Zwackelmann/brewbot/3D/temp-module-bot-case.stl

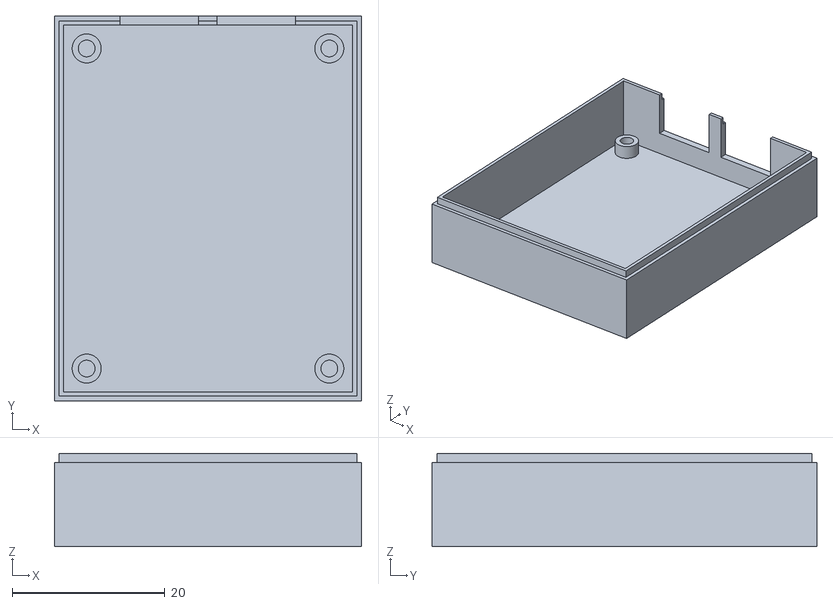
[picture p1: CAD file, 2024-01-14]
3D/temp-module-bot-case.stl
40.2 x 50.4 x 12.2
