Zwackelmann/brewbot/3D/temp-module.FCStd

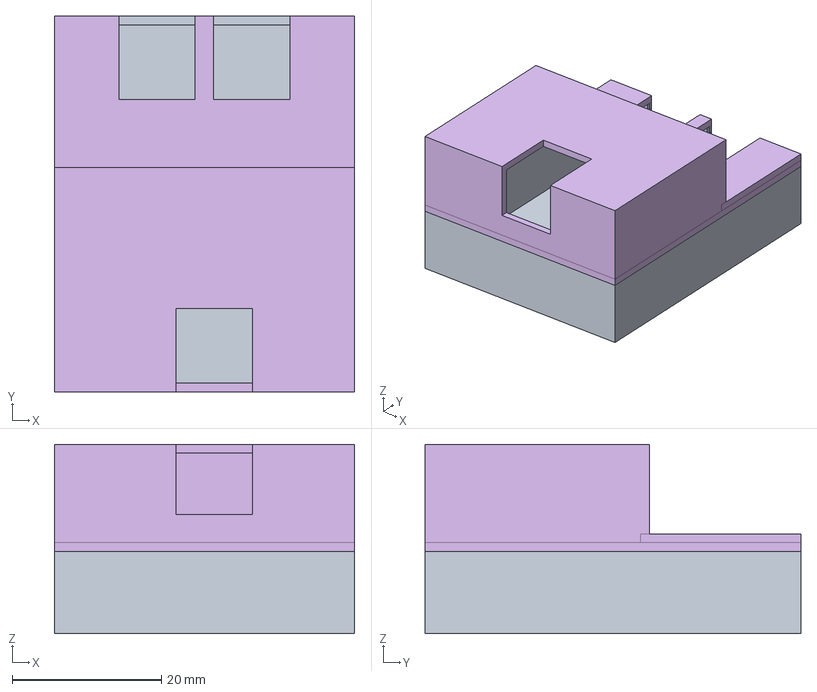
[picture p2: CAD file, 2024-01-14]
3D/temp-module.FCStd
40.2 x 50.4 x 25.4 mm
Tube
Tube001
Tube002
Tube003
