Zwackelmann/brewbot/3D/temp-module-top-case.stl

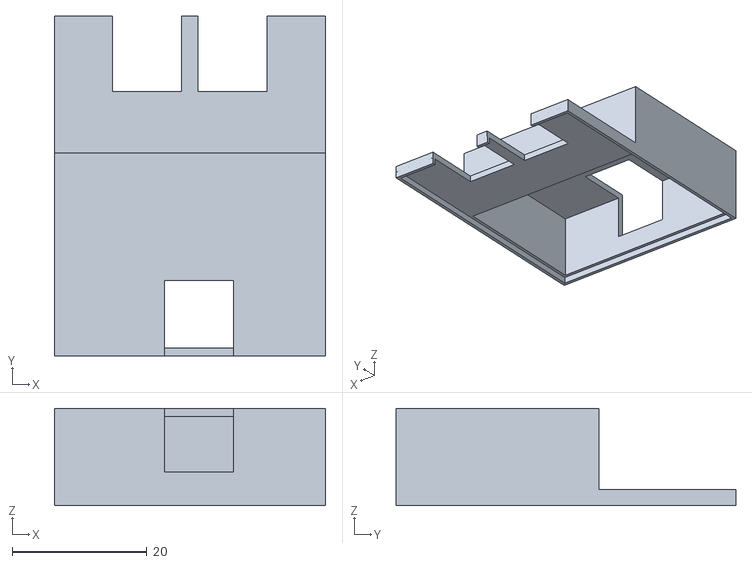
[picture p3: CAD file, 2024-01-14]
3D/temp-module-top-case.stl
40.2 x 50.4 x 14.4
