Zwackelmann/brewbot/3D/screw_demo.FCStd

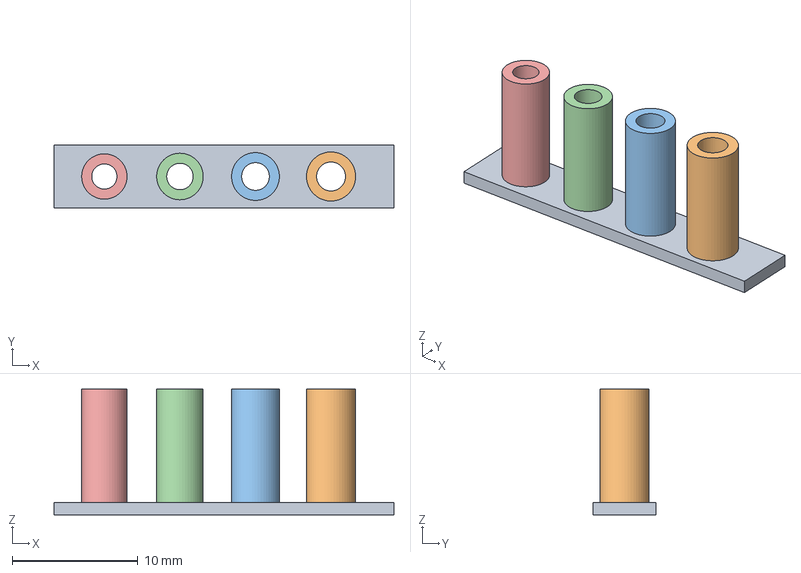
[picture p4: CAD file, 2024-01-06]
3D/screw_demo.FCStd
27.0 x 5.00 x 10.0 mm
