Zwackelmann/brewbot/pcb/motor-module/motor-module.kicad_pcb

## KiCad design pcb/motor-module/motor-module.kicad_pcb (2025-08-07)

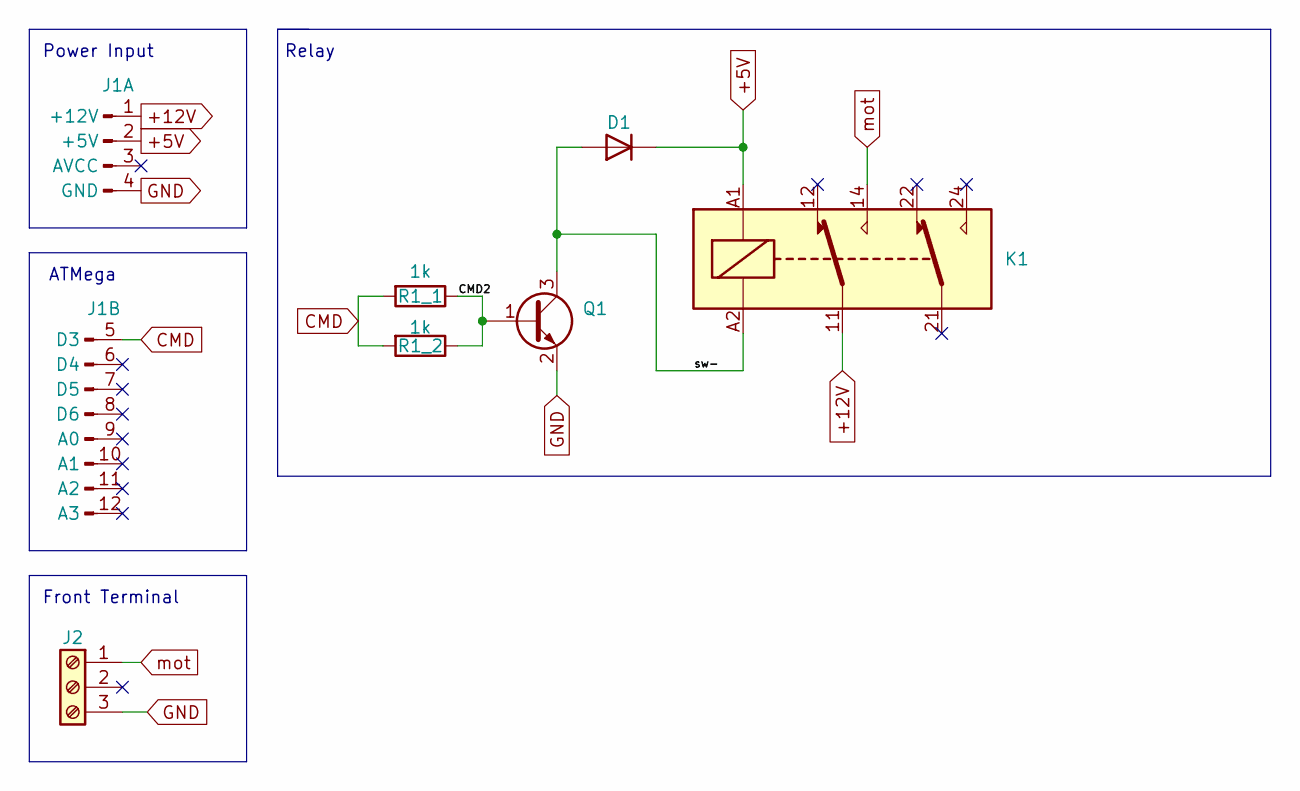
[picture p5: schematic motor-module.kicad_sch]

Parts:
D1: GS1A Gleichrichterdiode, 50 V, 1 A, DO-214AC/SMA; D_SMA
J1: Connector_male_4x8
J2: Screw_Terminal_01x03; Wago_734-163_1x03_P3.50mm_Horizontal
K1: AZ822-2C-5DSE Signal-Relais, 5 V DC, 2 A, 2 CO; Relay_DPDT_Finder_30.22
Q1: 2N 2222A SMD Bipolartransistor, NPN, 40V, 0,8A, 0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; SOT-23
R1_1, R1_2: 1k; R_0805_2012Metric

Connections:
+5V: D1.1 (K), J1.2 (+5V), K1.A1
+12V: J1.1 (+12V), K1.11
/CMD2: Q1.1 (B), R1_1.1, R1_2.1
/sw-: D1.2 (A), K1.A2, Q1.3 (C)
CMD: J1.5 (D3), R1_1.2, R1_2.2
GND: J1.4 (GND), J2.3, Q1.2 (E)
mot: J2.1, K1.14

Notes on the sheet:
ATMega
Power Input
Relay
Front Terminal

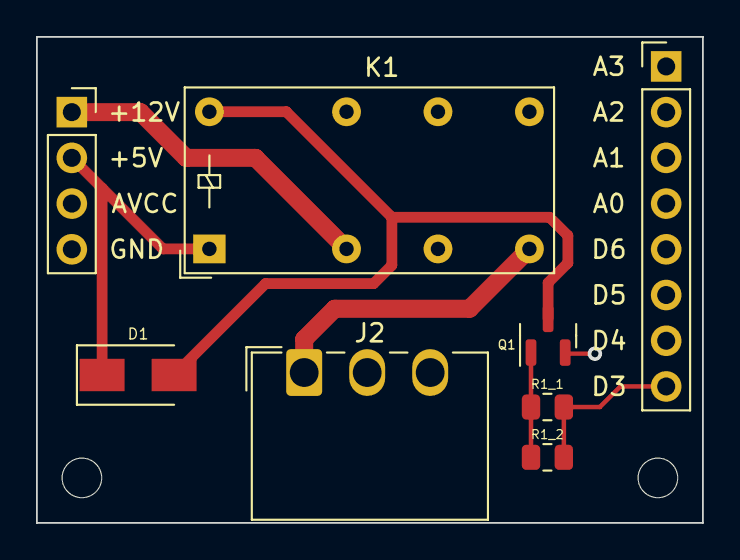
[picture p6: board motor-module.kicad_pcb from above]

Board: 2 copper layers, 37.0 x 27.0 mm, 7 parts (0 on the bottom side), 7 nets.
