Zwackelmann/brewbot/pcb/can-atmega/can-atmega.kicad_pcb

## KiCad design pcb/can-atmega/can-atmega.kicad_pcb (2025-07-05)

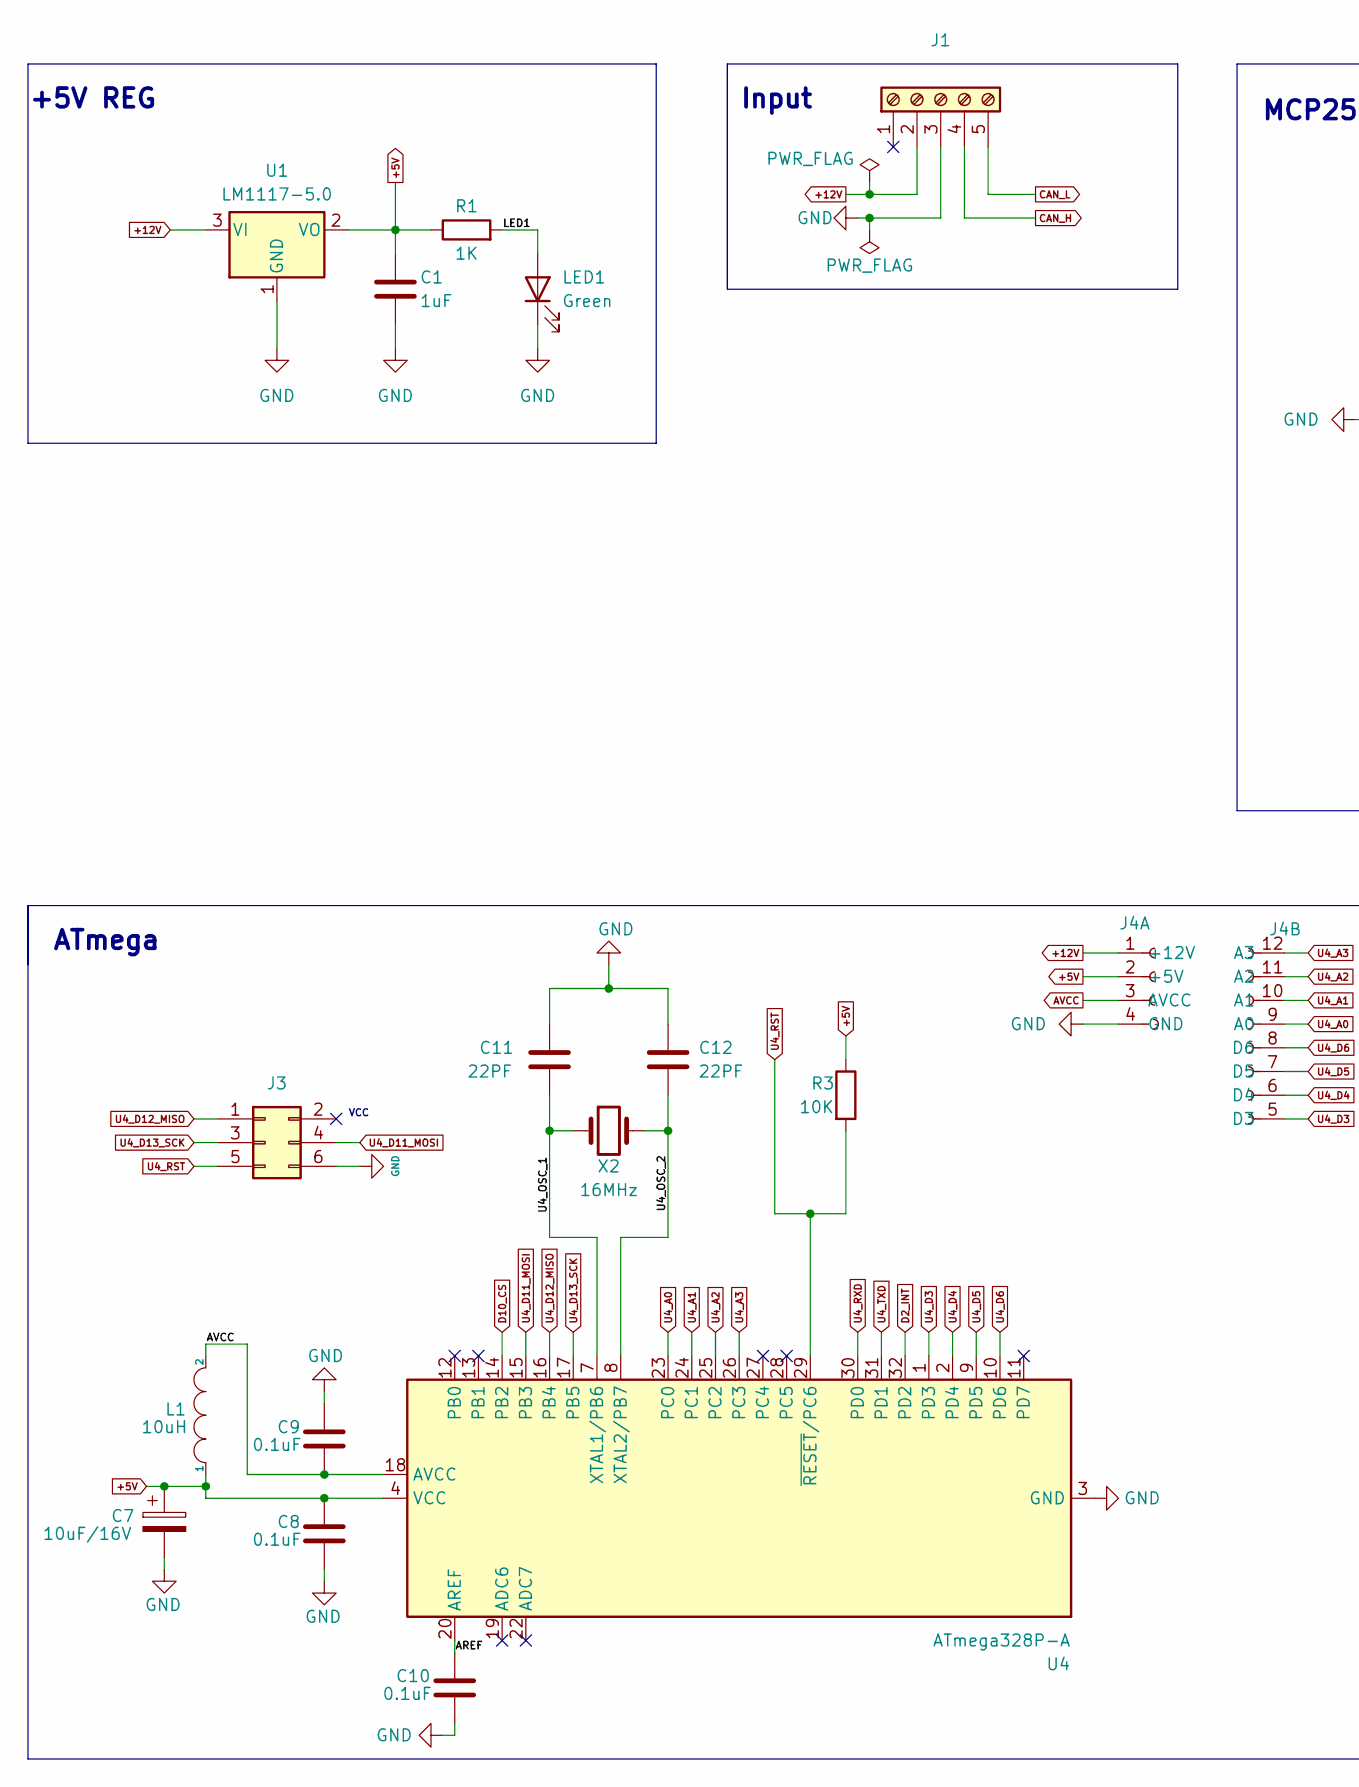
[picture p7: schematic can-atmega.kicad_sch, part in row 1, column 1]

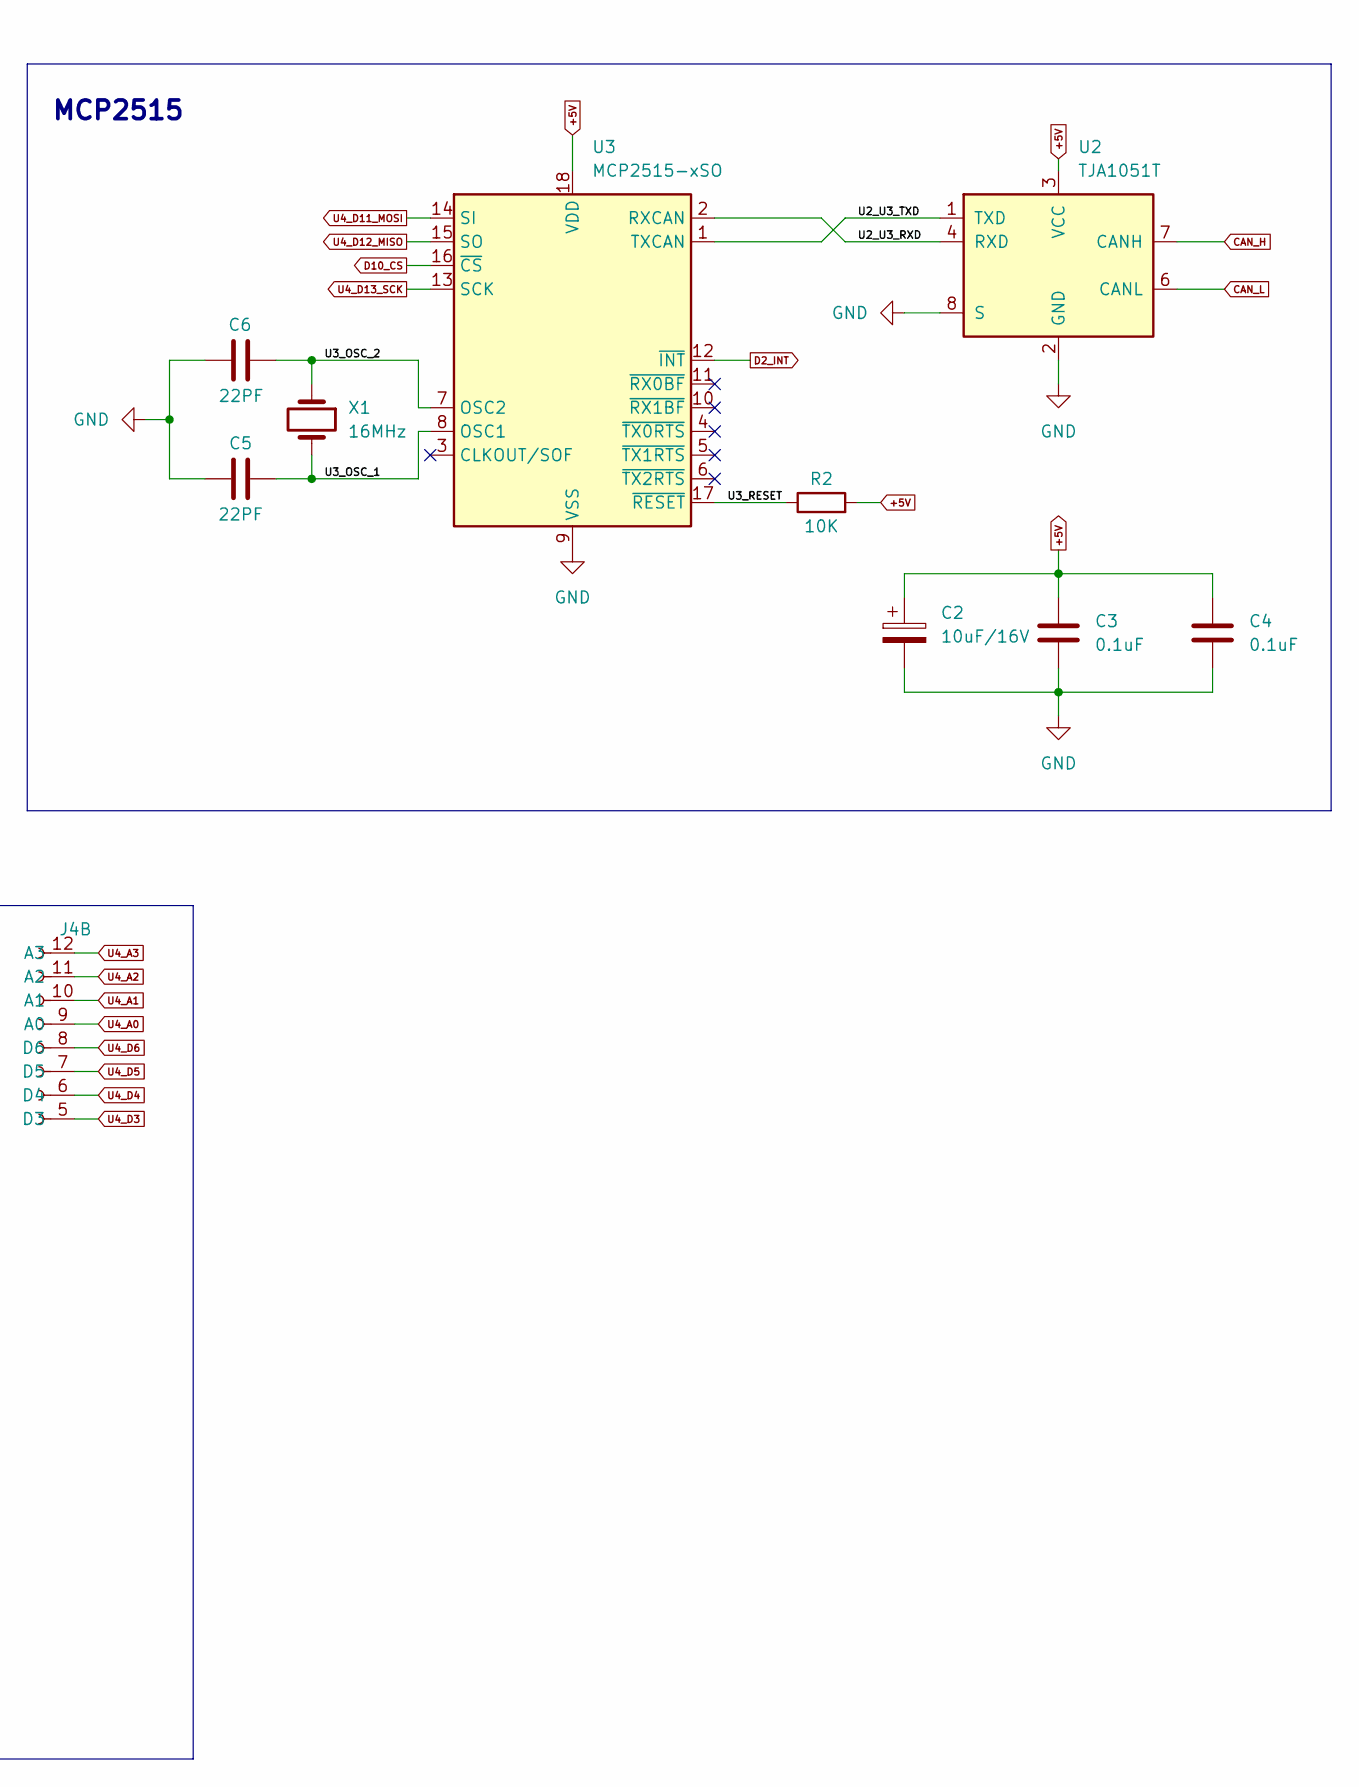
[picture p8: schematic can-atmega.kicad_sch, part in row 1, column 2]

Parts:
C1: 1uF; C_1206_3216Metric
C2, C7: 10uF/16V; CP_EIA-3216-18_Kemet-A
C3, C4, C8, C9, C10: 0.1uF; C_1206_3216Metric
C5, C6, C11, C12: 22PF; C_1206_3216Metric
J1: Screw_Terminal_01x05; 4301207
J3: Conn_02x03_Odd_Even; IDC-Header_2x03_P2.54mm_Vertical
J4: Connector_female_4x8
L1: 10uH; L_Neosid_SMS-ME3010
LED1: Green; LED_0805_2012Metric
R1: 1K; R_0805_2012Metric
R2, R3: 10K; R_0805_2012Metric
U1: LM1117-5.0; SOT-223
U2: TJA1051T; SOIC-8_3.9x4.9mm_P1.27mm
U3: MCP2515-xSO; SOIC-18W_7.5x11.6mm_P1.27mm
U4: ATmega328P-A; TQFP-32_7x7mm_P0.8mm
X1, X2: 16MHz; Crystal_HC49-4H_Vertical

Connections:
+5V: C1.1, C2.1, C3.1, C4.1, C7.1, C8.1, J4.2 (+5V), L1.1, R1.1, R2.2, R3.1, U1.2 (VO), U1.4, U2.3 (VCC), U3.18 (VDD), U4.4 (VCC), U4.6 (VCC)
+12V: J1.2, J4.1 (+12V), U1.3 (VI)
/AREF: C10.2, U4.20 (AREF)
/LED1: LED1.2 (A), R1.2
/U2_U3_RXD: U2.4 (RXD), U3.2 (RXCAN)
/U2_U3_TXD: U2.1 (TXD), U3.1 (TXCAN)
/U3_OSC_1: C5.2, U3.8 (OSC1), X1.2
/U3_OSC_2: C6.2, U3.7 (OSC2), X1.1
/U3_RESET: R2.1, U3.17 (~RESET)
/U4_OSC_1: C11.1, U4.7 (XTAL1/PB6), X2.1
/U4_OSC_2: C12.2, U4.8 (XTAL2/PB7), X2.2
AVCC: C9.2, J4.3 (AVCC), L1.2, U4.18 (AVCC)
CAN_H: J1.4, U2.7 (CANH)
CAN_L: J1.5, U2.6 (CANL)
D2_INT: U3.12 (~INT), U4.32 (PD2)
D10_CS: U3.16 (~CS), U4.14 (PB2)
GND: C1.2, C2.2, C3.2, C4.2, C5.1, C6.1, C7.2, C8.2, C9.1, C10.1, C11.2, C12.1, J1.3, J3.6, J4.4 (GND), LED1.1 (K), U1.1 (GND), U2.2 (GND), U2.8 (S), U3.9 (VSS), U4.3 (GND), U4.5 (GND), U4.21 (GND)
U4_A0: J4.9 (A0), U4.23 (PC0)
U4_A1: J4.10 (A1), U4.24 (PC1)
U4_A2: J4.11 (A2), U4.25 (PC2)
U4_A3: J4.12 (A3), U4.26 (PC3)
U4_D3: J4.5 (D3), U4.1 (PD3)
U4_D4: J4.6 (D4), U4.2 (PD4)
U4_D5: J4.7 (D5), U4.9 (PD5)
U4_D6: J4.8 (D6), U4.10 (PD6)
U4_D11_MOSI: J3.4, U3.14 (SI), U4.15 (PB3)
U4_D12_MISO: J3.1, U3.15 (SO), U4.16 (PB4)
U4_D13_SCK: J3.3, U3.13 (SCK), U4.17 (PB5)
U4_RST: J3.5, R3.2, U4.29 (~RESET/PC6)
U4_RXD: U4.30 (PD0)
U4_TXD: U4.31 (PD1)

Notes on the sheet:
+5V REG
ATmega
MCP2515
VCC
Input

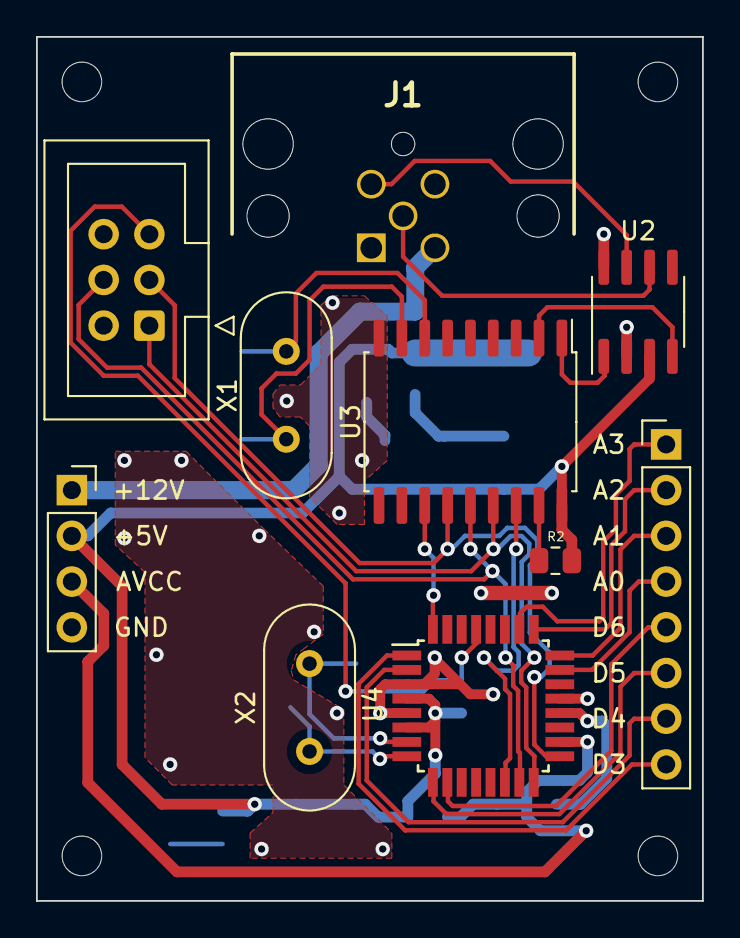
[picture p9: board can-atmega.kicad_pcb from above]

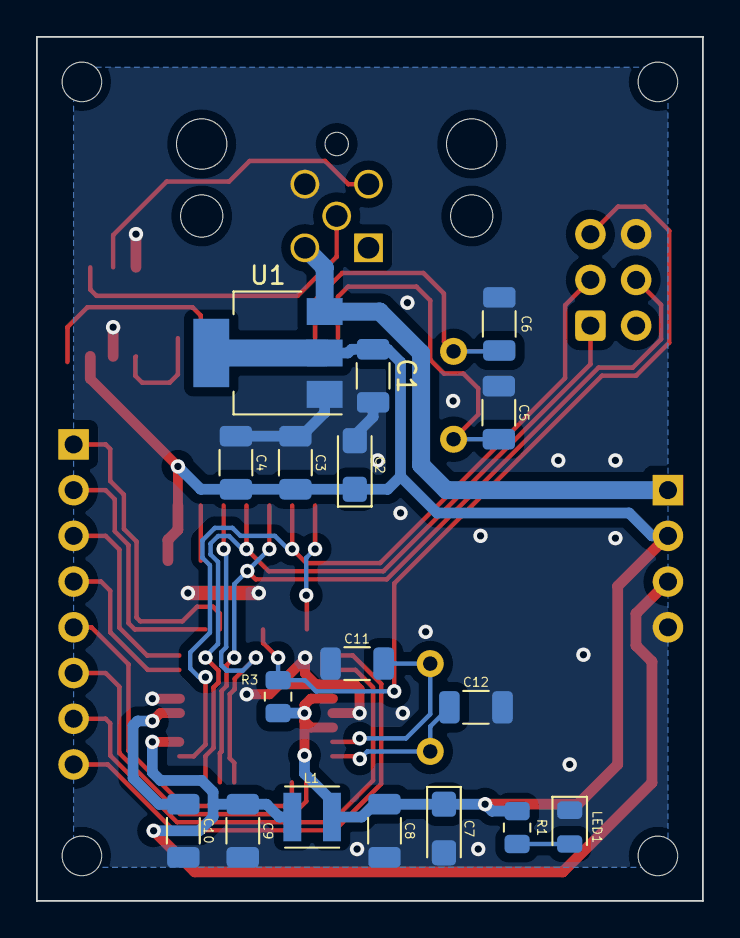
[picture p10: board can-atmega.kicad_pcb from below]

Board: 2 copper layers, 37.0 x 48.0 mm, 26 parts (17 on the bottom side), 29 nets.
