Zwackelmann/brewbot/pcb/temp-module/temp-module.kicad_pcb

## KiCad design pcb/temp-module/temp-module.kicad_pcb (2025-07-03)

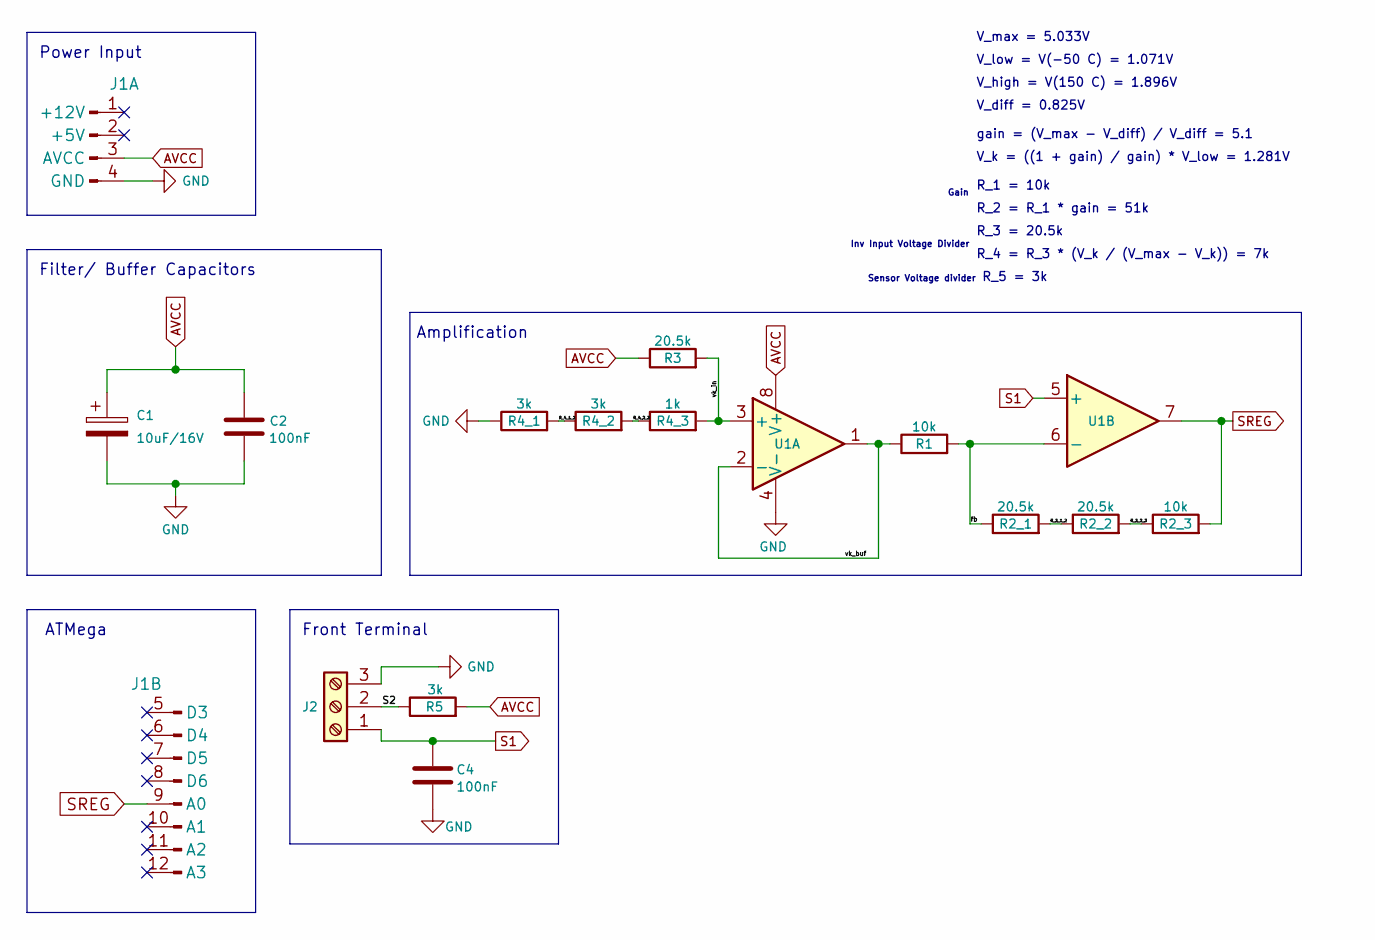
[picture p11: schematic temp-module.kicad_sch]

Parts:
C1: 10uF/16V; C_1206_3216Metric
C2, C4: 100nF; C_1206_3216Metric
J1: Connector_male_4x8
J2: Screw_Terminal_01x03; Wago_734-163_1x03_P3.50mm_Horizontal
R1, R2_3: 10k; R_0805_2012Metric
R2_1, R2_2, R3: 20.5k; R_0805_2012Metric
R4_1, R4_2, R5: 3k; R_0805_2012Metric
R4_3: 1k; R_0805_2012Metric
U1: MCP6002-xP; DIP-8_W7.62mm

Connections:
/R_2_1_2: R2_1.2, R2_2.1
/R_2_2_3: R2_2.2, R2_3.1
/R_4_1_2: R4_1.2, R4_2.1
/R_4_2_3: R4_2.2, R4_3.1
/S2: J2.2, R5.1
/fb: R1.2, R2_1.1, U1.6 (-)
/vk_buf: R1.1, U1.1, U1.2 (-)
/vk_in: R3.2, R4_3.2, U1.3 (+)
AVCC: C1.1, C2.1, J1.3 (AVCC), R3.1, R5.2, U1.8 (V+)
GND: C1.2, C2.2, C4.2, J1.4 (GND), J2.3, R4_1.1, U1.4 (V-)
S1: C4.1, J2.1, U1.5 (+)
SREG: J1.9 (A0), R2_3.2, U1.7

Notes on the sheet:
gain = (V_max - V_diff) / V_diff = 5.1
Inv Input Voltage Divider
Gain
V_high = V(150 C) = 1.896V
R_4 = R_3 * (V_k / (V_max - V_k)) = 7k
V_max = 5.033V
V_diff = 0.825V
Amplification
Front Terminal
Sensor Voltage divider
R_5 = 3k
Filter/ Buffer Capacitors
V_k = ((1 + gain) / gain) * V_low = 1.281V
ATMega
Power Input
V_low = V(-50 C) = 1.071V
R_2 = R_1 * gain = 51k
R_3 = 20.5k
R_1 = 10k

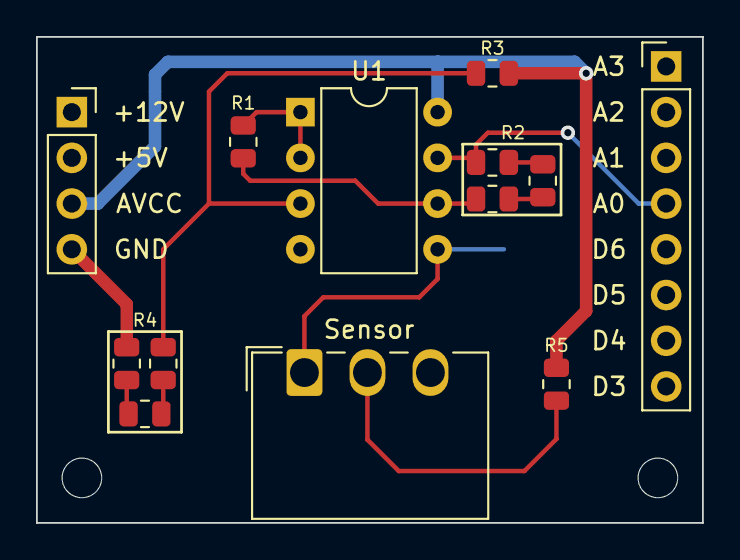
[picture p12: board temp-module.kicad_pcb from above]

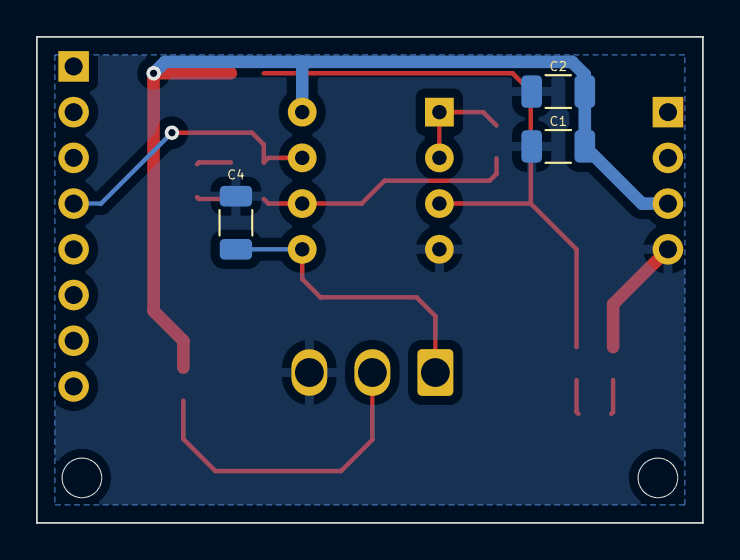
[picture p13: board temp-module.kicad_pcb from below]

Board: 2 copper layers, 37.0 x 27.0 mm, 15 parts (3 on the bottom side), 12 nets.
