Zwackelmann/brewbot/pcb/temp-sensor/temp-sensor.kicad_pcb

## KiCad design pcb/temp-sensor/temp-sensor.kicad_pcb (2024-01-06)

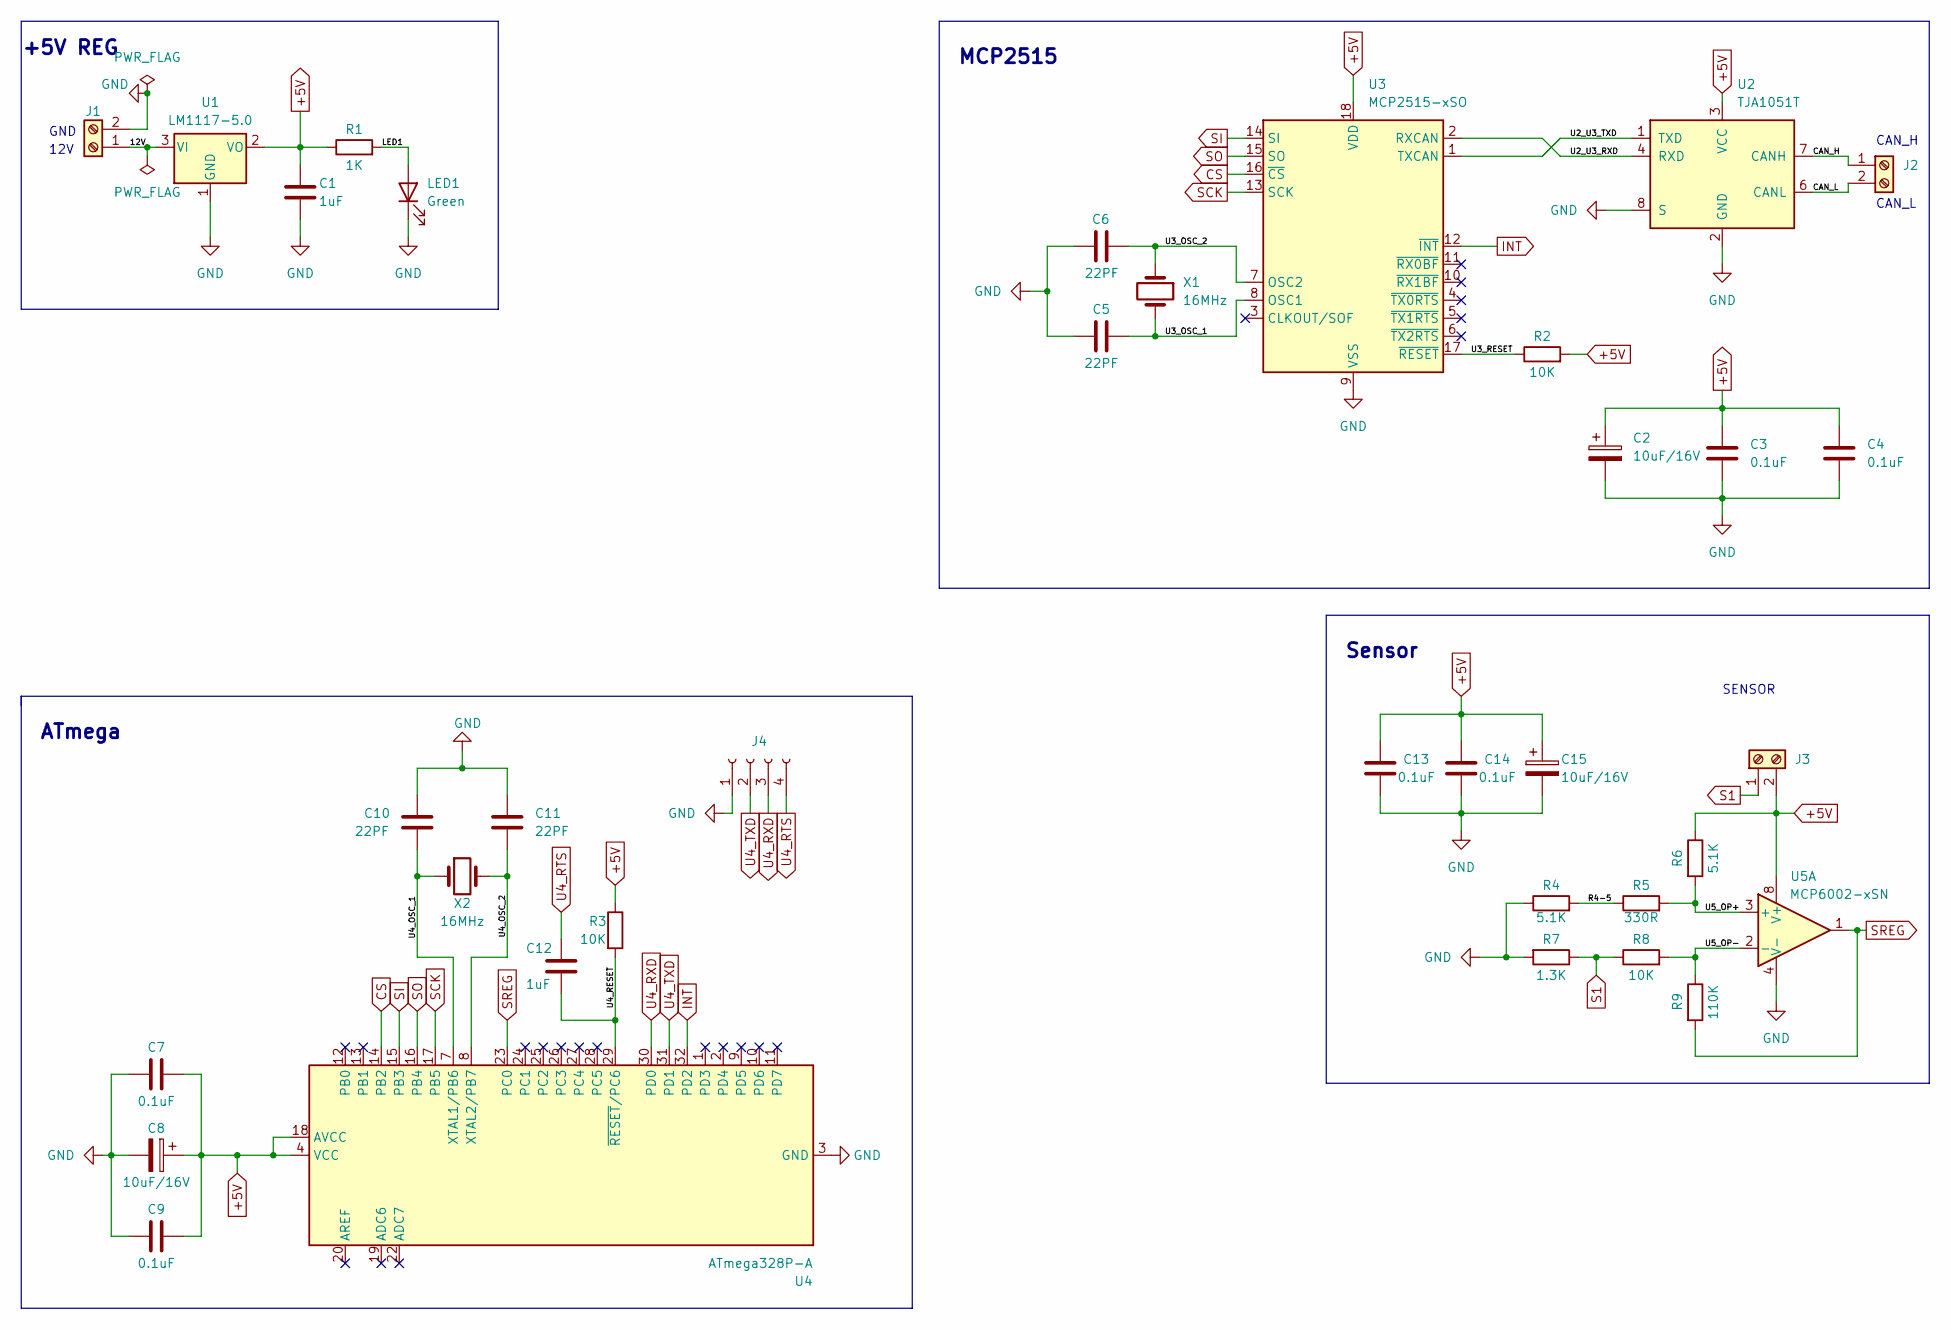
[picture p14: schematic temp-sensor.kicad_sch]

Parts:
C1, C12: 1uF; C_KEM_0805_2.0x1.25mm
C2, C8, C15: 10uF/16V; C_TAJ_3516_Bauform_A
C3, C4, C7, C9, C13, C14: 0.1uF; C_KEM_0805_2.0x1.25mm
C5, C6, C10, C11: 22PF; C_KEM_0805_2.0x1.25mm
J1, J2, J3: Screw_Terminal_01x02; TerminalBlock_bornier-2_P5.08mm
J4: Conn_01x04_Female; PinHeader_1x04_P2.54mm_Vertical
LED1: Green; LED_EL_0603_GR1_1608
R1: 1K; R_SPR-0603_1.6x0.8mm
R2, R3, R8: 10K; R_SPR-0603_1.6x0.8mm
R4, R6: 5.1K; R_SPR-0603_1.6x0.8mm
R5: 330R; R_SPR-0603_1.6x0.8mm
R7: 1.3K; R_SPR-0603_1.6x0.8mm
R9: 110K; R_SPR-0603_1.6x0.8mm
U1: LM1117-5.0; SOT-223
U2: TJA1051T; SOIC-8_3.9x4.9mm_P1.27mm
U3: MCP2515-xSO; SOIC-18W_7.5x11.6mm_P1.27mm
U4: ATmega328P-A; TQFP-32_7x7mm_P0.8mm
U5: MCP6002-xSN; DIP-8_W7.62mm
X1, X2: 16MHz; Crystal_HC49-4H_Vertical

Connections:
+5V: C1.1, C2.1, C3.1, C4.1, C7.1, C8.1, C9.1, C13.1, C14.2, C15.1, J3.2, R1.1, R2.2, R3.1, R6.1, U1.2 (VO), U2.3 (VCC), U3.18 (VDD), U4.4 (VCC), U4.6 (VCC), U4.18 (AVCC), U5.8 (V+)
/12V: J1.1, U1.3 (VI)
/CAN_H: J2.1, U2.7 (CANH)
/CAN_L: J2.2, U2.6 (CANL)
/LED1: LED1.2 (A), R1.2
/R4-5: R4.2, R5.1
/U2_U3_RXD: U2.4 (RXD), U3.2 (RXCAN)
/U2_U3_TXD: U2.1 (TXD), U3.1 (TXCAN)
/U3_OSC_1: C5.2, U3.8 (OSC1), X1.2
/U3_OSC_2: C6.2, U3.7 (OSC2), X1.1
/U3_RESET: R2.1, U3.17 (~RESET)
/U4_OSC_1: C10.1, U4.7 (XTAL1/PB6), X2.1
/U4_OSC_2: C11.2, U4.8 (XTAL2/PB7), X2.2
/U4_RESET: C12.2, R3.2, U4.29 (~RESET/PC6)
/U5_OP+: R5.2, R6.2, U5.3 (+)
/U5_OP-: R8.2, R9.1, U5.2 (-)
CS: U3.16 (~CS), U4.14 (PB2)
GND: C1.2, C2.2, C3.2, C4.2, C5.1, C6.1, C7.2, C8.2, C9.2, C10.2, C11.1, C13.2, C14.1, C15.2, J1.2, J4.1, LED1.1 (K), R4.1, R7.2, U1.1 (GND), U2.2 (GND), U2.8 (S), U3.9 (VSS), U4.3 (GND), U4.5 (GND), U4.21 (GND), U5.4 (V-)
INT: U3.12 (~INT), U4.32 (PD2)
S1: J3.1, R7.1, R8.1
SCK: U3.13 (SCK), U4.17 (PB5)
SI: U3.14 (SI), U4.15 (PB3)
SO: U3.15 (SO), U4.16 (PB4)
SREG: R9.2, U4.23 (PC0), U5.1
U4_RTS: C12.1, J4.4
U4_RXD: J4.3, U4.30 (PD0)
U4_TXD: J4.2, U4.31 (PD1)

Notes on the sheet:
CAN_H
+5V REG
12V
Sensor
CAN_L
ATmega
MCP2515
GND
SENSOR

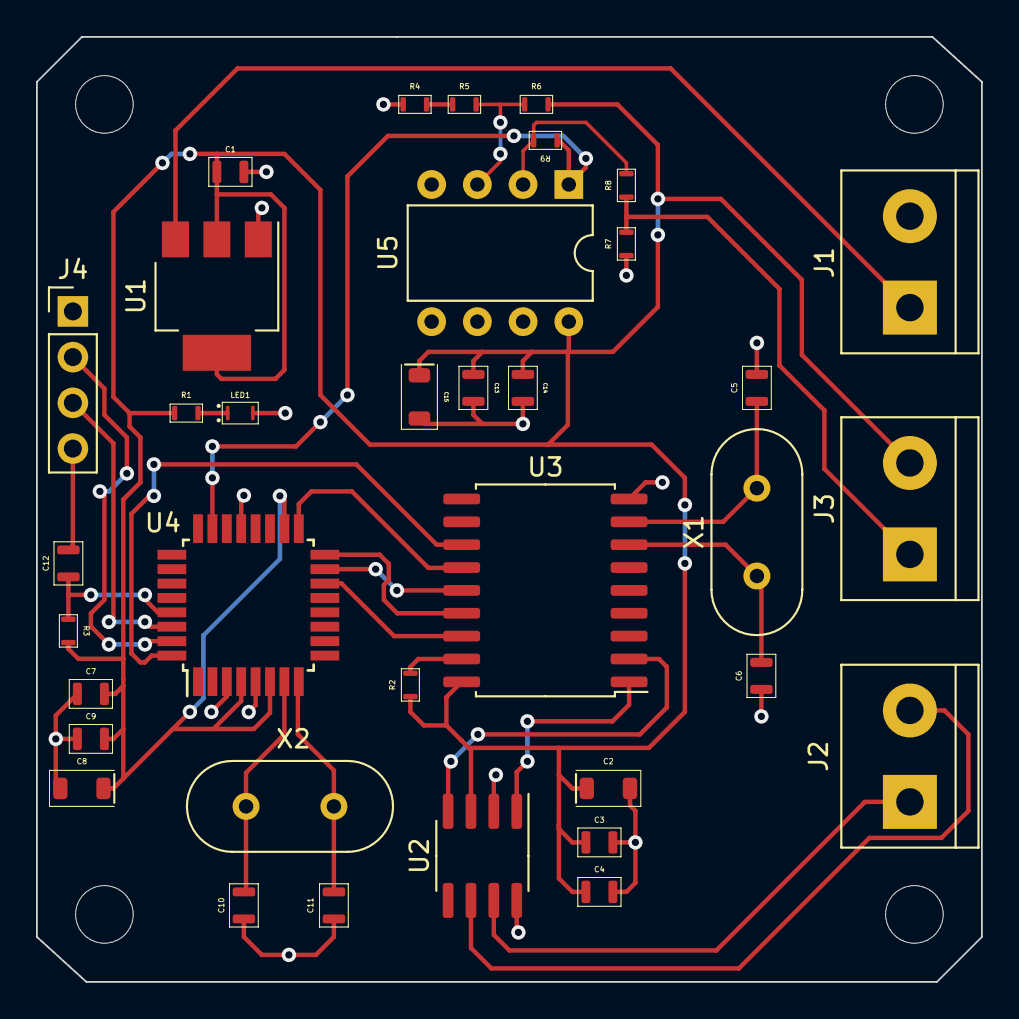
[picture p15: board temp-sensor.kicad_pcb from above]

Board: 2 copper layers, 52.5 x 52.5 mm, 36 parts (0 on the bottom side), 27 nets.
