Zwackelmann/brewbot/arduino/heat_plate_relay/util.h

#ifndef J1939_UTIL_H
#define J1939_UTIL_H

#define NODE_ADDR     0x81u
#define MASTER_ADDR   0x10u
#define NODE_TYPE     NodeType::Relay
#define NODE_ID       1u

#define VERSION_MAJOR 1
#define VERSION_MINOR 10
#define VERSION_PATCH 23

enum class NodeType : uint8_t {
  Unknown     = 0,
  Thermometer = 1,
  Relay       = 2,
  Pressure    = 3,
};

/* Scheduler */
static inline bool time_due(uint32_t now, uint32_t next) {
  return (int32_t)(now - next) >= 0;
}

using schedule_handler_t = void (*)();

struct schedule_item_t {
  uint32_t period_ms;
  uint32_t next_at;
  schedule_handler_t f;
};

template<size_t N>
struct Scheduler {
  schedule_item_t items[N];

  void tick() {
    const uint32_t now = millis();
    for (size_t i = 0; i < N; ++i) {
      auto &it = items[i];
      if (!it.f) continue;
      if (time_due(now, it.next_at)) {
        it.f();
        // catch-up: preserve phase if we slipped
        do { it.next_at += it.period_ms; } while (time_due(now, it.next_at));
      }
    }
  }
};

/* J1939 */
class J1939 {
public:
  static constexpr uint8_t ANY_ADDR = 0xFEu;  // not a real address
  static constexpr uint8_t BROADCAST_ADDR = 0xFFu;
  static constexpr uint32_t CAN_EFF_ID_MASK = 0x1FFFFFFFu;  // 29 bit mask

  static constexpr size_t MAX_MSG_DISPS = 8;

  using dispatch_fn_t = void (*)(const can_frame* frame, void* msg_disp);

  struct reg_item_t {
    uint32_t      pgn;
    size_t        dlc;
    uint8_t       src;     // J1939::ANY_ADDR means "any"
    uint8_t       dest;    // J1939::ANY_ADDR means "any"; J1939::BROADCAST_ADDR is actual 0xFF
    dispatch_fn_t dispatch_fn;
    void*         msg_disp;
  };

  explicit J1939() : _n(0) {}

  static inline uint8_t pdu_format(const uint32_t pgn) noexcept {
    return ((pgn >> 8) & 0xFFu);
  }

  static inline uint8_t is_pdu_format_1(const uint32_t pgn) noexcept {
    return J1939::pdu_format(pgn) < 0xF0u;
  }

  static inline uint8_t is_pdu_format_2(const uint32_t pgn) noexcept {
    return J1939::pdu_format(pgn) >= 0xF0u;
  }

  static inline uint32_t pgn_to_can_id(const uint32_t pgn, const uint8_t priority, const uint8_t src_addr, const uint8_t dest_addr) noexcept {
    uint32_t pgn_encoded = pgn;
    if(J1939::is_pdu_format_1(pgn)) {
      pgn_encoded &= 0xFF00u;  // clear dest_addr part
      pgn_encoded |= (dest_addr & 0xFFu);
    }

    uint8_t dp = (pgn_encoded >> 16) & 0x1u;
    uint8_t pf = (pgn_encoded >> 8) & 0xFFu;
    uint8_t ps = pgn_encoded & 0xFFu;

    uint32_t can_id = 0;
    can_id |= ((uint32_t)(priority & 0x7u)) << 26;
    can_id |= ((uint32_t)(dp & 0x1u)) << 24;
    can_id |= ((uint32_t)(pf & 0xFFu)) << 16;
    can_id |= ((uint32_t)(ps & 0xFFu)) << 8;
    can_id |= ((uint32_t)(src_addr & 0xFFu)) << 0;

    return can_id;
  }

  static inline uint32_t can_id_to_pgn(const uint32_t can_id) noexcept {
    uint32_t ps = (can_id >> 8) & 0xFFu;
    uint32_t pf = (can_id >> 16) & 0xFFu;
    uint32_t dp = (can_id >> 24) & 0x1u;

    uint32_t pgn = ps;
    pgn |= (pf << 8);
    pgn |= (dp << 16);

    if(is_pdu_format_1(pgn)) {
      pgn = (pgn & 0x1FF00u);
    }

    return pgn;
  }

  static inline uint8_t can_id_to_src_addr(const uint32_t can_id) noexcept {
    return can_id & 0xFFu;
  }

  static inline uint8_t can_id_to_dest_addr(const uint32_t can_id) noexcept {
    uint32_t pgn = (can_id >> 8) & 0x1FFFFu;

    if(is_pdu_format_1(pgn)) {
      return pgn & 0xFFu;
    } else {
      return 0xFFu;
    }
  }

  static inline uint8_t can_id_to_priority(const uint32_t can_id) noexcept {
    return (can_id >> 26) & 0x7u;
  }

  static inline void array_shift(uint8_t *data, size_t dlen, int by) noexcept {
    if(dlen == 0 || by == 0) {
      return;
    }

    bool shift_right = by > 0;
    if(!shift_right) {
      by = -by;
    }

    if (by >= (int)(dlen * 8)) {
      memset(data, 0, dlen);
      return;
    }

    size_t by_bytes = by/8;
    size_t by_bits = by%8;

    if(by_bytes != 0) {
      if(shift_right) {
        for(size_t i=0; i<dlen-by_bytes; ++i) {
          data[dlen-1-i] = data[dlen-1-i-by_bytes];
        }

        for(size_t i=0; i<by_bytes; ++i) {
          data[i] = 0x00u;
        }
      } else {
        for(size_t i=0; i<dlen-by_bytes; ++i) {
          data[i] = data[i+by_bytes];
        }

        for(size_t i=0; i<by_bytes; ++i) {
          data[dlen-i-1] = 0x00u;
        }
      }
    }

    if(by_bits != 0) {
      if(shift_right) {
        for(size_t i=dlen-1; i>0; --i) {
          data[i] = (data[i] >> by_bits);
          data[i] = (data[i] | ((data[i-1] & (0xFFu >> (8-by_bits))) << (8-by_bits)));
        }

        data[0] = (data[0] >> by_bits);
      } else {
        for(size_t i=0; i<dlen-1; ++i) {
          data[i] = (data[i] << by_bits);
          data[i] = (data[i] | ((data[i+1] & (0xFFu << (8-by_bits))) >> (8-by_bits)));
        }

        data[dlen-1] = (data[dlen-1] << by_bits);
      }
    }
  }

  static inline bool encode_uint(const uint32_t n, uint8_t *data, size_t dlen, size_t start_bit, size_t signal_size) noexcept {
    size_t n_bytes = (signal_size + 7) / 8;
    if (n_bytes > 4) n_bytes = 4;

    uint8_t num[4] = {0};

    // MSB-first packing into num[]
    for(size_t i=0; i<n_bytes; ++i) {
      const size_t shift = 8 * (n_bytes - 1 - i);
      num[i] = (uint8_t)((n >> shift) & 0xFFu);
    }

    return J1939::inject(data, dlen, num, n_bytes, start_bit, signal_size);
  }

  static inline bool encode_int(const int32_t n, uint8_t *data, size_t dlen, size_t start_bit, size_t signal_size) noexcept {
    uint32_t u;
    if (signal_size == 0) {
      return false;
    } else if (signal_size >= 32) {
      u = (uint32_t)n;  // natural two's complement
    } else {
      const uint32_t mask = (1UL << signal_size) - 1UL;
      u = ((uint32_t)n) & mask;
    }

    return encode_uint(u, data, dlen, start_bit, signal_size);
  }

  static inline uint32_t decode_uint(const uint8_t *data, size_t dlen, size_t start_bit, size_t signal_size) noexcept {
    size_t r_bytes = ((start_bit + signal_size - 1) / 8) - (start_bit / 8) + 1;
    if(r_bytes > 5) r_bytes = 5;

    uint8_t num[5] = {0};  // up to 32 bits
    project(data, dlen, num, r_bytes, start_bit, signal_size);

    uint32_t v = 0;
    for (size_t i=0; i<r_bytes; ++i) {
      v = (v << 8) | num[i];
    }

    if (signal_size < 32) {
      const uint32_t mask = (signal_size == 32) ? 0xFFFFFFFFUL : ((1UL << signal_size) - 1UL);
      v &= mask;
    }

    return v;
  }

  static inline int32_t decode_int(const uint8_t *data, size_t dlen, size_t start_bit, size_t signal_size) noexcept {
    uint32_t u = decode_uint(data, dlen, start_bit, signal_size);

    if (signal_size == 0) {
      return 0;
    } else if(signal_size < 32) {
      const uint32_t sign_mask = 1UL << (signal_size - 1);
      if (u & sign_mask) {
        // sign-extend
        const uint32_t ext = ~((1UL << signal_size) - 1UL);
        u |= ext;
      }
    }
    return (int32_t)u;
  }

  static inline bool inject(uint8_t *data, size_t dlen, uint8_t *num, size_t nlen, size_t start_bit, size_t signal_size) noexcept {
    if (signal_size == 0 || nlen == 0) return false;

    const size_t n_bytes = ((start_bit + signal_size - 1) / 8) - (start_bit / 8) + 1;

    uint8_t mask[9] = {0};
    uint8_t shift[9] = {0};

    inject_mask(mask, signal_size, n_bytes);
    array_shift(mask, n_bytes, -(int)(start_bit % 8));

    const size_t pad = (n_bytes > nlen) ? (n_bytes - nlen) : 0;
    for (size_t i = 0; i < n_bytes; ++i) {
      shift[i] = (i < pad) ? 0 : num[i - pad];
    }
    array_shift(shift, n_bytes, -(int)(start_bit % 8));

    const size_t first = start_bit / 8;
    for (size_t i = 0; i < n_bytes; ++i) {
      const size_t di = first + i;
      if (di >= dlen) break;
      const size_t n_idx = n_bytes - 1 - i;
      data[di] = (uint8_t)((data[di] & (uint8_t)~mask[n_idx]) | (shift[n_idx] & mask[n_idx]));
    }

    return true;
  }

  static inline void inject_mask(uint8_t *mask, const size_t signal_size, const size_t n_bytes) noexcept {
    for(size_t i=0; i<n_bytes; ++i) {
      size_t hb = (signal_size-1) / 8;
      size_t mb = static_cast<size_t>(n_bytes-hb-1);

      if(i < mb) {
        mask[i] = 0x00u;
      } else if (i == mb) {
        mask[i] = 0xFFu >> ((8 - (signal_size % 8)) % 8);
      } else {
        mask[i] = 0xFFu;
      }
    }
  }

  static inline void project(const uint8_t *data, size_t dlen, uint8_t *num, size_t nlen, size_t start_bit, size_t signal_size) noexcept {
    const size_t hi     = start_bit + signal_size;
    const size_t rbytes = ((hi - 1) / 8) - (start_bit / 8) + 1;
    const size_t count  = (rbytes < nlen) ? rbytes : nlen;

    for (size_t i=0; i<count; ++i) {
      const size_t d_idx = (start_bit / 8) + rbytes - 1 - i;
      if (d_idx < dlen) num[i] = data[d_idx];
    }
    const uint8_t tail_mask = 0xFFu >> ((8 - (hi % 8)) % 8);
    if (count) num[0] &= tail_mask;
    J1939::array_shift(num, nlen, start_bit % 8);
  }

  template<typename MsgDispT>
  bool register_disp(MsgDispT* msg_disp, uint8_t src = ANY_ADDR, uint8_t dest = ANY_ADDR) noexcept {
    if (_n >= MAX_MSG_DISPS || !msg_disp) return false;
    _reg[_n++] = reg_item_t{
      MsgDispT::PGN,
      MsgDispT::DLC,
      src,
      dest,
      &J1939::dispatch_frame_adapter<MsgDispT>, 
      msg_disp
    };
    return true;
  }

  bool process_frame(const can_frame* frame) const noexcept {
    if (!frame) return false;
    const uint32_t can_id = frame->can_id & CAN_EFF_ID_MASK;
    const uint32_t pgn    = J1939::can_id_to_pgn(can_id);
    const uint8_t  src    = J1939::can_id_to_src_addr(can_id);
    const uint8_t  dest   = J1939::can_id_to_dest_addr(can_id);

    for (size_t i=0; i<_n; ++i) {
      const reg_item_t& reg_item = _reg[i];
      if (pgn == reg_item.pgn &&
          (reg_item.src  == ANY_ADDR || src  == reg_item.src) &&
          (reg_item.dest == ANY_ADDR || dest == reg_item.dest) &&
          frame->can_dlc == reg_item.dlc) {
        reg_item.dispatch_fn(frame, reg_item.msg_disp);
        return true;
      }
    }

    return false;
  }

private:
  template<typename MsgDispT>
  static void dispatch_frame_adapter(const can_frame* frame, void* msg_disp) noexcept {
    static_cast<MsgDispT*>(msg_disp)->dispatch_frame(frame);
  }

  reg_item_t _reg[MAX_MSG_DISPS];
  size_t     _n;
};


/* Message Dispatcher */
class RelayCmdDisp {
public:
  using handler_t = void (*)(uint8_t, void*);

  static constexpr uint32_t PGN      = 0x1000u;
  static constexpr uint8_t  PRIORITY = 6u;
  static constexpr size_t   DLC      = 8;

  RelayCmdDisp() : _handler(_handle_noop), _ctx(nullptr) {}

  static inline void prepare(can_frame* frame, const uint8_t src, const uint8_t dest = J1939::BROADCAST_ADDR) noexcept {
    frame->can_id = J1939::pgn_to_can_id(PGN, PRIORITY, src, dest) | CAN_EFF_FLAG;
    frame->can_dlc = DLC;

    memset(frame->data, 0, sizeof frame->data);
  }

  static inline uint8_t decode_signal_on(const can_frame* frame) noexcept {
    return J1939::decode_uint(frame->data, DLC, 0, 1);
  }
  static inline bool encode_signal_on(can_frame* frame, const uint8_t v) noexcept {
    if (v > 1) return false;
    return J1939::encode_uint(v, frame->data, DLC, 0, 1);
  }

  void dispatch_frame(const can_frame* frame) noexcept {
    const uint8_t on = decode_signal_on(frame);
    _handler(on, _ctx);
  }

  void set_handler(handler_t h, void* ctx=nullptr) noexcept {
    _handler = h ? h : _handle_noop;
    _ctx = ctx;
  }

private:
  static void _handle_noop(uint8_t, void*) {}
  handler_t _handler;
  void* _ctx;
};


class RelayStatusDisp {
public:
  using handler_t = void (*)(uint8_t, void*);

  static constexpr uint32_t PGN      = 0xFF11u;
  static constexpr uint8_t  PRIORITY = 6u;
  static constexpr size_t   DLC      = 8;

  RelayStatusDisp() : _handler(_handle_noop), _ctx(nullptr) {}

  static inline void prepare(can_frame* frame, const uint8_t src, const uint8_t dest = J1939::BROADCAST_ADDR) noexcept {
    frame->can_id = J1939::pgn_to_can_id(PGN, PRIORITY, src, dest) | CAN_EFF_FLAG;
    frame->can_dlc = DLC;

    memset(frame->data, 0, sizeof frame->data);
  }

  static inline uint8_t decode_signal_on(const can_frame* frame) noexcept {
    return J1939::decode_uint(frame->data, DLC, 0, 1);
  }
  static inline bool encode_signal_on(can_frame* frame, const uint8_t v) noexcept {
    if (v > 1) return false;
    return J1939::encode_uint(v, frame->data, DLC, 0, 1);
  }

  void dispatch_frame(const can_frame* frame) noexcept {
    const uint8_t on = decode_signal_on(frame);
    _handler(on, _ctx);
  }

  void set_handler(handler_t h, void* ctx=nullptr) noexcept {
    _handler = h ? h : _handle_noop;
    _ctx = ctx;
  }

private:
  static void _handle_noop(uint8_t, void*) {}
  handler_t _handler;
  void* _ctx;
};


class NodeInfoDisp {
public:
  using handler_t = void (*)(uint8_t, uint8_t, uint8_t, uint8_t, uint8_t, uint32_t, void*);

  static constexpr uint32_t PGN      = 0xFF00u;
  static constexpr uint8_t  PRIORITY = 6u;
  static constexpr size_t   DLC      = 8;

  NodeInfoDisp() : _handler(_handle_noop), _ctx(nullptr) {}

  static inline void prepare(can_frame* frame, const uint8_t src, const uint8_t dest = J1939::BROADCAST_ADDR) noexcept {
    frame->can_id = J1939::pgn_to_can_id(PGN, PRIORITY, src, dest) | CAN_EFF_FLAG;
    frame->can_dlc = DLC;

    memset(frame->data, 0, sizeof frame->data);
  }

  static inline uint8_t decode_signal_node_type(const can_frame* frame) noexcept {
    return J1939::decode_uint(frame->data, DLC, 0, 7);
  }
  static inline bool encode_signal_node_type(can_frame* frame, const uint8_t v) noexcept {
    if (v > 127) return false;
    return J1939::encode_uint(v, frame->data, DLC, 0, 7);
  }

  static inline uint8_t decode_signal_node_id(const can_frame* frame) noexcept {
    return J1939::decode_uint(frame->data, DLC, 7, 7);
  }
  static inline bool encode_signal_node_id(can_frame* frame, const uint8_t v) noexcept {
    if (v > 127) return false;
    return J1939::encode_uint(v, frame->data, DLC, 7, 7);
  }

  static inline uint8_t decode_signal_version_major(const can_frame* frame) noexcept {
    return J1939::decode_uint(frame->data, DLC, 14, 6);
  }
  static inline bool encode_signal_version_major(can_frame* frame, const uint8_t v) noexcept {
    if (v > 63) return false;
    return J1939::encode_uint(v, frame->data, DLC, 14, 6);
  }

  static inline uint8_t decode_signal_version_minor(const can_frame* frame) noexcept {
    return J1939::decode_uint(frame->data, DLC, 20, 6);
  }
  static inline bool encode_signal_version_minor(can_frame* frame, const uint8_t v) noexcept {
    if (v > 63) return false;
    return J1939::encode_uint(v, frame->data, DLC, 20, 6);
  }

  static inline uint8_t decode_signal_version_patch(const can_frame* frame) noexcept {
    return J1939::decode_uint(frame->data, DLC, 26, 6);
  }
  static inline bool encode_signal_version_patch(can_frame* frame, const uint8_t v) noexcept {
    if (v > 63) return false;
    return J1939::encode_uint(v, frame->data, DLC, 26, 6);
  }

  static inline uint32_t decode_signal_uptime(const can_frame* frame) noexcept {
    return J1939::decode_uint(frame->data, DLC, 32, 32);
  }
  static inline bool encode_signal_uptime(can_frame* frame, const uint32_t v) noexcept {
    return J1939::encode_uint(v, frame->data, DLC, 32, 32);
  }

  void dispatch_frame(const can_frame* frame) {
    const uint8_t node_type = decode_signal_node_type(frame);
    const uint8_t node_id = decode_signal_node_id(frame);
    const uint8_t version_major = decode_signal_version_major(frame);
    const uint8_t version_minor = decode_signal_version_minor(frame);
    const uint8_t version_patch = decode_signal_version_patch(frame);
    const uint32_t uptime = decode_signal_uptime(frame);
    _handler(node_type, node_id, version_major, version_minor, version_patch, uptime, _ctx);
  }

  void set_handler(handler_t h, void* ctx=nullptr) {
    _handler = h ? h : _handle_noop;
    _ctx = ctx;
  }

private:
  static void _handle_noop(uint8_t, uint8_t, uint8_t, uint8_t, uint8_t, uint32_t, void*) {}
  handler_t _handler;
  void* _ctx;
};

#endif
