Zwackelmann/brewbot/(commit log)

2024-01-06 added pcb and 3d files
    [screw_demo.FCStd, temp-sensor.kicad_pcb, temp-sensor.kicad_sch]
2024-01-07 modified pcbs
    [can-atmega.kicad_pcb, can-atmega.kicad_sch, temp-module.kicad_pcb, temp-module.kicad_sch]
2024-01-14 motor module
    [can-atmega.kicad_pcb, can-atmega.kicad_sch, can_atmega-layout.kicad_pcb, motor-module.kicad_pcb, motor-module.kicad_sch, temp-module-bot-case.stl, temp-module-top-case.stl, temp-module.FCStd]
2024-01-15 update pcb
    [can-atmega.kicad_pcb, can-atmega.kicad_sch, motor-module.kicad_pcb, motor-module.kicad_sch, temp-module.kicad_pcb, temp-module.kicad_sch]
2024-03-30 added AVRISP adapter to pcb
    [can-atmega-02-layout.kicad_pcb, can-atmega-02-layout.kicad_sch, can-atmega-02.kicad_pcb, can-atmega-02.kicad_sch, can-atmega.kicad_pcb, can_atmega-layout.kicad_pcb, motor-module.kicad_pcb, temp-module.kicad_pcb]
2024-04-14 m12 plug; j1939 transition
    [can-atmega-02-layout.kicad_pcb, can-atmega-02-layout2.kicad_pcb, can-atmega-02.kicad_pcb, can-atmega-02.kicad_sch, can-atmega-layout.kicad_pcb, can-atmega-layout.kicad_sch, can-atmega.kicad_pcb, can-atmega.kicad_sch]
2024-09-08 added pid
2024-10-20 calibrate plots
2024-10-30 new temp module
    [can-atmega-02-layout2.kicad_pcb, temp-module.kicad_pcb, temp-module.kicad_sch]
2025-01-10 board updates
2025-06-14 updated pcb
    [can-atmega.kicad_pcb, can-atmega.kicad_sch]
2025-07-03 pcb update
    [can-atmega.kicad_pcb, can-atmega.kicad_sch, motor-module.kicad_pcb, motor-module.kicad_sch, temp-module.kicad_pcb, temp-module.kicad_sch]
2025-07-05 pcb fab 2025-07-04
    [can-atmega-layout-2025-07-01.kicad_pcb, can-atmega.kicad_pcb, can-atmega.kicad_sch, motor-module.kicad_pcb]
2025-08-07 generated dbc files
    [motor-module.kicad_pcb]
